captmicr0/Bosch_ME7.1_2.7T_Simulator/Bosch_ME7.1_2.7T_Simulator.png

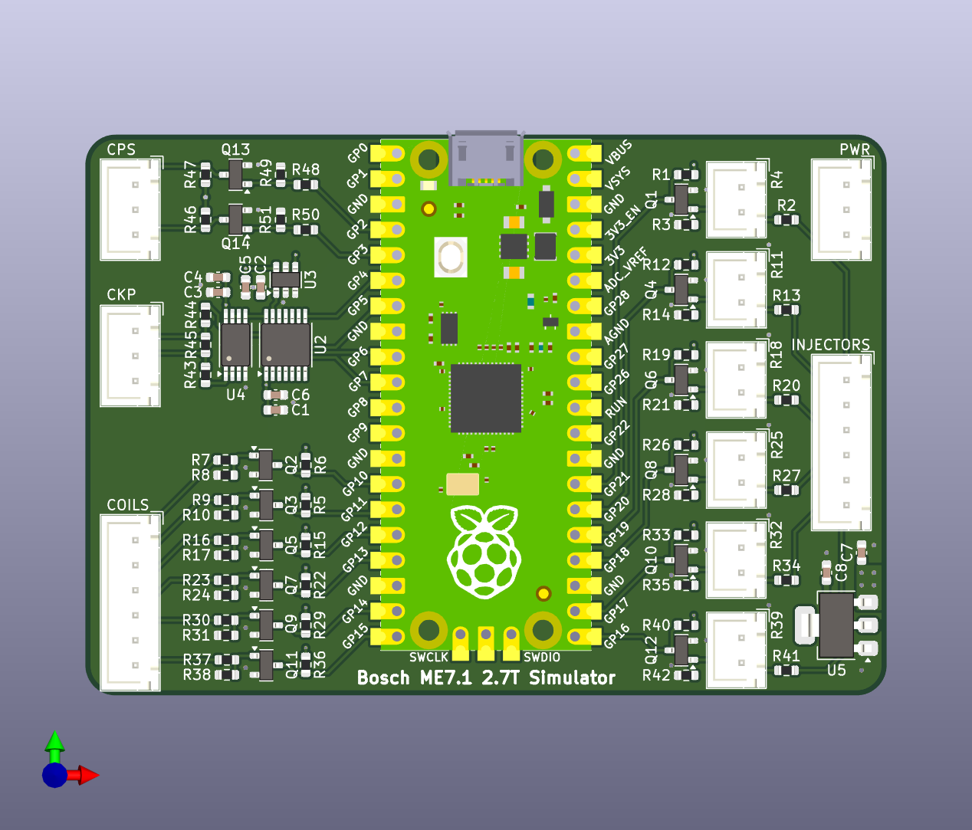
Bosch_ME7.1_2.7T_Simulator.png
