captmicr0/Bosch_ME7.1_2.7T_Simulator/software/Screenshot 2026-11-01 201432.png

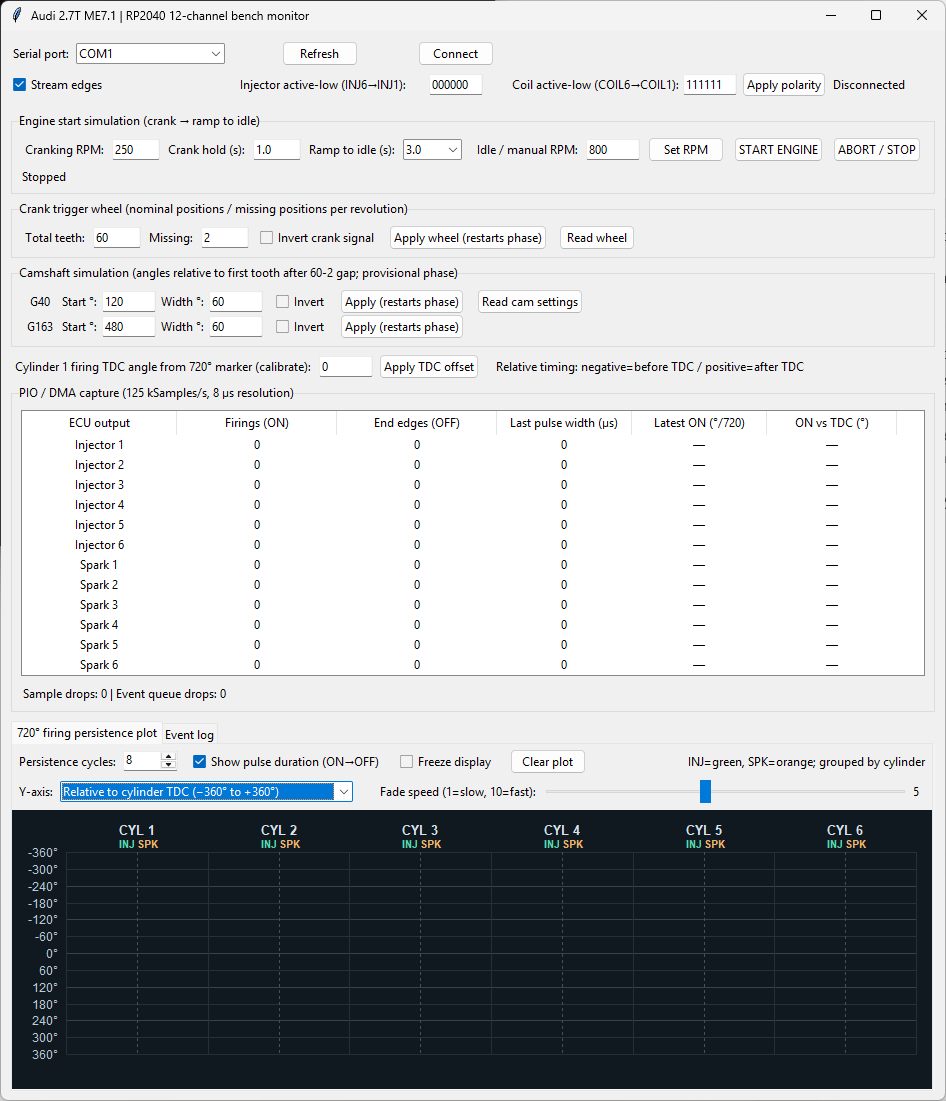
software/Screenshot 2026-11-01 201432.png
