captmicr0/Bosch_ME7.1_2.7T_Simulator/production/bom.csv

Designator | Footprint | Quantity | Value | LCSC Part #
C1, C4, C5, C7, C8 | 0603 | 5 | 1uF
C2, C3, C6 | 0603 | 3 | 100nF
J1 | JST_XH_B6B-XH-AM_1x06_P2.50mm_Vertical | 1 | INJECTORS
J2 | JST_XH_B6B-XH-AM_1x06_P2.50mm_Vertical | 1 | COILS
J3 | JST_XH_B3B-XH-AM_1x03_P2.50mm_Vertical | 1 | CKP
J4 | JST_XH_B3B-XH-AM_1x03_P2.50mm_Vertical | 1 | CPS
J5 | JST_XH_B3B-XH-AM_1x03_P2.50mm_Vertical | 1 | PWR
Q1, Q10, Q11, Q12, Q13, Q14, Q2, Q3, Q4, Q5, Q6, Q7, Q8, Q9 | SOT-23 | 14 | 2N7002
R1, R12, R13, R15, R19, R2, R20, R22, R26, R27, R29, R33, R34, R36, R40, R41, R46, R47, R5, R6 | 0603 | 20 | 4.7k
R10, R17, R24, R31, R38, R49, R51, R8 | 0603 | 8 | 10k
R11, R18, R25, R32, R39, R4 | JST_XH_B2B-XH-AM_1x02_P2.50mm_Vertical | 6 | 15
R14, R21, R28, R3, R35, R42 | 0603 | 6 | 2.2k
R16, R23, R30, R37, R48, R50, R7, R9 | 0603 | 8 | 1k
R43, R44 | 0603 | 2 | 100
R45 | 0603 | 1 | 820
U1 | RPi_Pico_SMD_TH | 1 | Pico
U2 | TSSOP-14_4.4x5mm_P0.65mm | 1 | MCP4922-EST
U3 | SOT-23-6 | 1 | MCP1501-20xCH
U4 | TSSOP-8_4.4x3mm_P0.65mm | 1 | TLV9062
U5 | SOT-223-3_TabPin2 | 1 | AMS1117-5.0
