captmicr0/Bosch_ME7.1_2.7T_Simulator/Bosch_ME7.1_2.7T_Simulator.kicad_pcb

## KiCad design Bosch_ME7.1_2.7T_Simulator.kicad_pcb (2026-11-01)

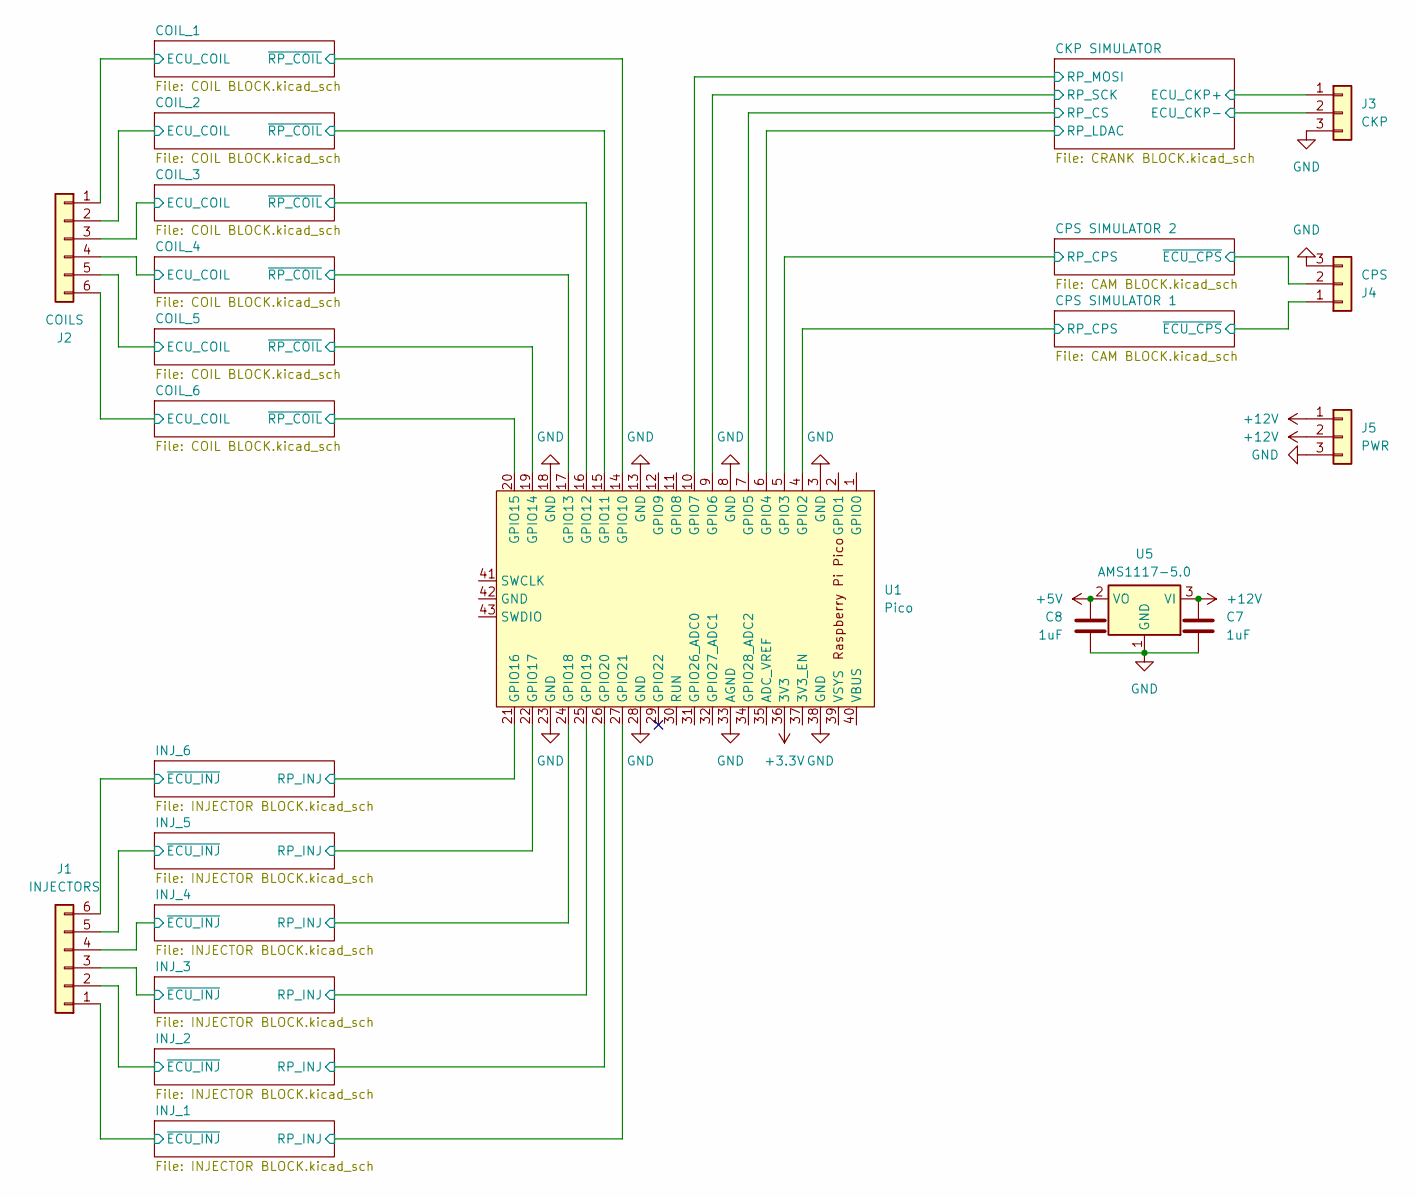
[picture p3: schematic Bosch_ME7.1_2.7T_Simulator.kicad_sch]

Parts:
C7, C8: 1uF; C_0603_1608Metric
J1: INJECTORS; JST_XH_B6B-XH-AM_1x06_P2.50mm_Vertical
J2: COILS; JST_XH_B6B-XH-AM_1x06_P2.50mm_Vertical
J3: CKP; JST_XH_B3B-XH-AM_1x03_P2.50mm_Vertical
J4: CPS; JST_XH_B3B-XH-AM_1x03_P2.50mm_Vertical
J5: PWR; JST_XH_B3B-XH-AM_1x03_P2.50mm_Vertical
U1: Pico; RPi_Pico_SMD_TH
U5: AMS1117-5.0; SOT-223-3_TabPin2

Connections:
+3.3V: U1.36 (3V3); also elsewhere on the board
+5V: C8.1, U5.2 (VO); also elsewhere on the board
+12V: C7.1, J5.1, J5.2, U5.3 (VI); also elsewhere on the board
/CKP SIMULATOR/ECU_CKP+: J3.1; also elsewhere on the board
/CKP SIMULATOR/ECU_CKP-: J3.2; also elsewhere on the board
/CKP SIMULATOR/RP_CS: U1.7 (GPIO5); also elsewhere on the board
/CKP SIMULATOR/RP_LDAC: U1.6 (GPIO4); also elsewhere on the board
/CKP SIMULATOR/RP_MOSI: U1.10 (GPIO7); also elsewhere on the board
/CKP SIMULATOR/RP_SCK: U1.9 (GPIO6); also elsewhere on the board
/COIL_1/ECU_COIL: J2.1; also elsewhere on the board
/COIL_1/~RP_COIL: U1.14 (GPIO10); also elsewhere on the board
/COIL_2/ECU_COIL: J2.2; also elsewhere on the board
/COIL_2/~RP_COIL: U1.15 (GPIO11); also elsewhere on the board
/COIL_3/ECU_COIL: J2.3; also elsewhere on the board
/COIL_3/~RP_COIL: U1.16 (GPIO12); also elsewhere on the board
/COIL_4/ECU_COIL: J2.4; also elsewhere on the board
/COIL_4/~RP_COIL: U1.17 (GPIO13); also elsewhere on the board
/COIL_5/ECU_COIL: J2.5; also elsewhere on the board
/COIL_5/~RP_COIL: U1.19 (GPIO14); also elsewhere on the board
/COIL_6/ECU_COIL: J2.6; also elsewhere on the board
/COIL_6/~RP_COIL: U1.20 (GPIO15); also elsewhere on the board
/CPS SIMULATOR 1/RP_CPS: U1.4 (GPIO2); also elsewhere on the board
/CPS SIMULATOR 1/~ECU_CPS: J4.1; also elsewhere on the board
/CPS SIMULATOR 2/RP_CPS: U1.5 (GPIO3); also elsewhere on the board
/CPS SIMULATOR 2/~ECU_CPS: J4.2; also elsewhere on the board
/INJ_1/RP_INJ: U1.27 (GPIO21); also elsewhere on the board
/INJ_1/~ECU_INJ: J1.1; also elsewhere on the board
/INJ_2/RP_INJ: U1.26 (GPIO20); also elsewhere on the board
/INJ_2/~ECU_INJ: J1.2; also elsewhere on the board
/INJ_3/RP_INJ: U1.25 (GPIO19); also elsewhere on the board
/INJ_3/~ECU_INJ: J1.3; also elsewhere on the board
/INJ_4/RP_INJ: U1.24 (GPIO18); also elsewhere on the board
/INJ_4/~ECU_INJ: J1.4; also elsewhere on the board
/INJ_5/RP_INJ: U1.22 (GPIO17); also elsewhere on the board
/INJ_5/~ECU_INJ: J1.5; also elsewhere on the board
/INJ_6/RP_INJ: U1.21 (GPIO16); also elsewhere on the board
/INJ_6/~ECU_INJ: J1.6; also elsewhere on the board
GND: C7.2, C8.2, J3.3, J4.3, J5.3, U1.3 (GND), U1.8 (GND), U1.13 (GND), U1.18 (GND), U1.23 (GND), U1.28 (GND), U1.33 (AGND), U1.38 (GND), U5.1 (GND); also elsewhere on the board

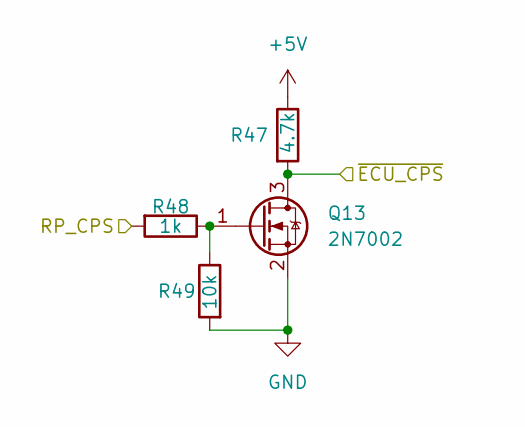
[picture p4: schematic CAM BLOCK.kicad_sch]

Parts:
Q13: 2N7002; SOT-23
R47: 4.7k; R_0603_1608Metric
R48: 1k; R_0603_1608Metric
R49: 10k; R_0603_1608Metric

Connections:
+5V: R47.1; also elsewhere on the board
/CPS SIMULATOR 1/RP_CPS: R48.2; also elsewhere on the board
/CPS SIMULATOR 1/~ECU_CPS: Q13.3 (D), R47.2; also elsewhere on the board
GND: Q13.2 (S), R49.2; also elsewhere on the board
unnamed: Q13.1 (G), R48.1, R49.1

Parts of its further copies:
Q14: 2N7002; SOT-23
R46: 4.7k; R_0603_1608Metric
R50: 1k; R_0603_1608Metric
R51: 10k; R_0603_1608Metric

Connections of its further copies:
+5V: R46.1; also elsewhere on the board
/CPS SIMULATOR 2/RP_CPS: R50.2; also elsewhere on the board
/CPS SIMULATOR 2/~ECU_CPS: Q14.3 (D), R46.2; also elsewhere on the board
GND: Q14.2 (S), R51.2; also elsewhere on the board
unnamed: Q14.1 (G), R50.1, R51.1

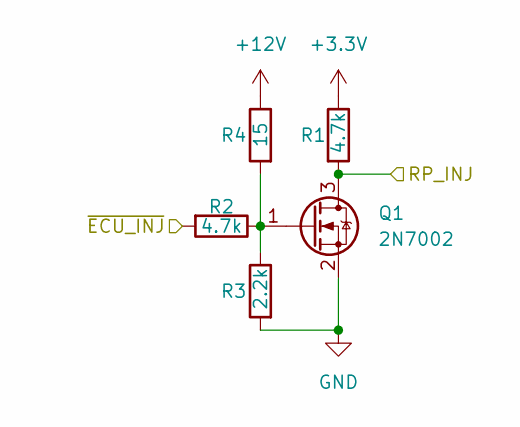
[picture p5: schematic INJECTOR BLOCK.kicad_sch]

Parts:
Q1: 2N7002; SOT-23
R1, R2: 4.7k; R_0603_1608Metric
R3: 2.2k; R_0603_1608Metric
R4: 15; JST_XH_B2B-XH-AM_1x02_P2.50mm_Vertical

Connections:
+3.3V: R1.1; also elsewhere on the board
+12V: R4.1; also elsewhere on the board
/INJ_1/RP_INJ: Q1.3 (D), R1.2; also elsewhere on the board
/INJ_1/~ECU_INJ: R2.2; also elsewhere on the board
GND: Q1.2 (S), R3.2; also elsewhere on the board
unnamed: Q1.1 (G), R2.1, R3.1, R4.2

Parts of its further copies:
Q4, Q6, Q8, Q10, Q12: 2N7002; SOT-23
R11, R18, R25, R32, R39: 15; JST_XH_B2B-XH-AM_1x02_P2.50mm_Vertical
R12, R13, R19, R20, R26, R27, R33, R34, R40, R41: 4.7k; R_0603_1608Metric
R14, R21, R28, R35, R42: 2.2k; R_0603_1608Metric

Connections of its further copies:
+3.3V: R12.1, R19.1, R26.1, R33.1, R40.1; also elsewhere on the board
+12V: R11.1, R18.1, R25.1, R32.1, R39.1; also elsewhere on the board
/INJ_2/RP_INJ: Q4.3 (D), R12.2; also elsewhere on the board
/INJ_2/~ECU_INJ: R13.2; also elsewhere on the board
/INJ_3/RP_INJ: Q6.3 (D), R19.2; also elsewhere on the board
/INJ_3/~ECU_INJ: R20.2; also elsewhere on the board
/INJ_4/RP_INJ: Q8.3 (D), R26.2; also elsewhere on the board
/INJ_4/~ECU_INJ: R27.2; also elsewhere on the board
/INJ_5/RP_INJ: Q10.3 (D), R33.2; also elsewhere on the board
/INJ_5/~ECU_INJ: R34.2; also elsewhere on the board
/INJ_6/RP_INJ: Q12.3 (D), R40.2; also elsewhere on the board
/INJ_6/~ECU_INJ: R41.2; also elsewhere on the board
GND: Q4.2 (S), Q6.2 (S), Q8.2 (S), Q10.2 (S), Q12.2 (S), R14.2, R21.2, R28.2, R35.2, R42.2; also elsewhere on the board
unnamed: Q4.1 (G), R11.2, R13.1, R14.1
unnamed: Q6.1 (G), R18.2, R20.1, R21.1
unnamed: Q8.1 (G), R25.2, R27.1, R28.1
unnamed: Q10.1 (G), R32.2, R34.1, R35.1
unnamed: Q12.1 (G), R39.2, R41.1, R42.1

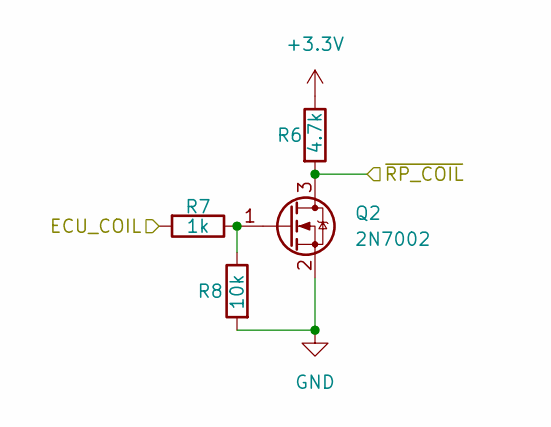
[picture p6: schematic COIL BLOCK.kicad_sch]

Parts:
Q2: 2N7002; SOT-23
R6: 4.7k; R_0603_1608Metric
R7: 1k; R_0603_1608Metric
R8: 10k; R_0603_1608Metric

Connections:
+3.3V: R6.1; also elsewhere on the board
/COIL_1/ECU_COIL: R7.2; also elsewhere on the board
/COIL_1/~RP_COIL: Q2.3 (D), R6.2; also elsewhere on the board
GND: Q2.2 (S), R8.2; also elsewhere on the board
unnamed: Q2.1 (G), R7.1, R8.1

Parts of its further copies:
Q3, Q5, Q7, Q9, Q11: 2N7002; SOT-23
R5, R15, R22, R29, R36: 4.7k; R_0603_1608Metric
R9, R16, R23, R30, R37: 1k; R_0603_1608Metric
R10, R17, R24, R31, R38: 10k; R_0603_1608Metric

Connections of its further copies:
+3.3V: R5.1, R15.1, R22.1, R29.1, R36.1; also elsewhere on the board
/COIL_2/ECU_COIL: R9.2; also elsewhere on the board
/COIL_2/~RP_COIL: Q3.3 (D), R5.2; also elsewhere on the board
/COIL_3/ECU_COIL: R16.2; also elsewhere on the board
/COIL_3/~RP_COIL: Q5.3 (D), R15.2; also elsewhere on the board
/COIL_4/ECU_COIL: R23.2; also elsewhere on the board
/COIL_4/~RP_COIL: Q7.3 (D), R22.2; also elsewhere on the board
/COIL_5/ECU_COIL: R30.2; also elsewhere on the board
/COIL_5/~RP_COIL: Q9.3 (D), R29.2; also elsewhere on the board
/COIL_6/ECU_COIL: R37.2; also elsewhere on the board
/COIL_6/~RP_COIL: Q11.3 (D), R36.2; also elsewhere on the board
GND: Q3.2 (S), Q5.2 (S), Q7.2 (S), Q9.2 (S), Q11.2 (S), R10.2, R17.2, R24.2, R31.2, R38.2; also elsewhere on the board
unnamed: Q3.1 (G), R9.1, R10.1
unnamed: Q5.1 (G), R16.1, R17.1
unnamed: Q7.1 (G), R23.1, R24.1
unnamed: Q9.1 (G), R30.1, R31.1
unnamed: Q11.1 (G), R37.1, R38.1

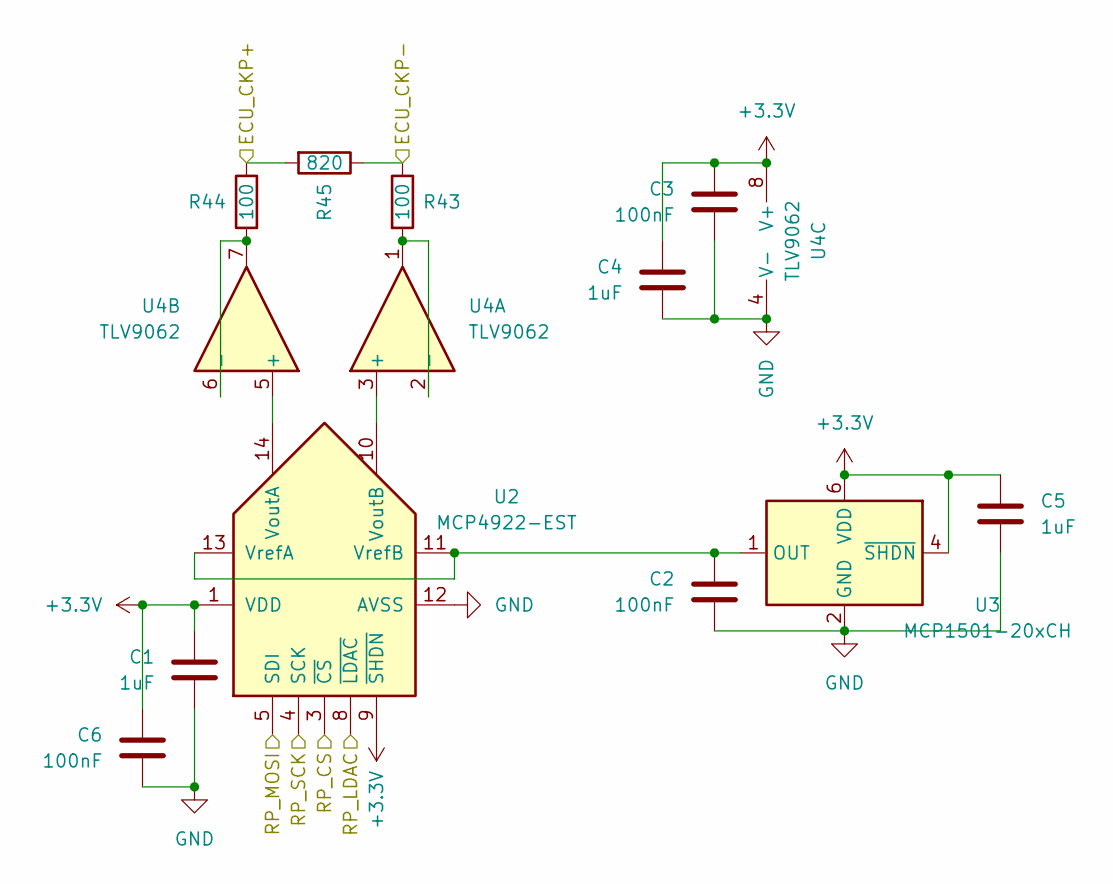
[picture p7: schematic CRANK BLOCK.kicad_sch]

Parts:
C1, C4, C5: 1uF; C_0603_1608Metric
C2, C3, C6: 100nF; C_0603_1608Metric
R43, R44: 100; R_0603_1608Metric
R45: 820; R_0603_1608Metric
U2: MCP4922-EST; TSSOP-14_4.4x5mm_P0.65mm
U3: MCP1501-20xCH; SOT-23-6
U4: TLV9062; TSSOP-8_4.4x3mm_P0.65mm

Connections:
+3.3V: C1.1, C3.1, C4.1, C5.1, C6.1, U2.1 (VDD), U2.9 (~SHDN), U3.4 (~SHDN), U3.6 (VDD), U4.8 (V+); also elsewhere on the board
/CKP SIMULATOR/ECU_CKP+: R44.1, R45.2; also elsewhere on the board
/CKP SIMULATOR/ECU_CKP-: R43.1, R45.1; also elsewhere on the board
/CKP SIMULATOR/RP_CS: U2.3 (~CS); also elsewhere on the board
/CKP SIMULATOR/RP_LDAC: U2.8 (~LDAC); also elsewhere on the board
/CKP SIMULATOR/RP_MOSI: U2.5 (SDI); also elsewhere on the board
/CKP SIMULATOR/RP_SCK: U2.4 (SCK); also elsewhere on the board
GND: C1.2, C2.2, C3.2, C4.2, C5.2, C6.2, U2.12 (AVSS), U3.2 (GND), U3.3 (GND), U3.5 (GND), U4.4 (V-); also elsewhere on the board
unnamed: U2.14 (VoutA), U4.5 (+)
unnamed: U2.10 (VoutB), U4.3 (+)
unnamed: C2.1, U2.11 (VrefB), U2.13 (VrefA), U3.1 (OUT)
unnamed: R43.2, U4.1, U4.2 (-)
unnamed: R44.2, U4.6 (-), U4.7

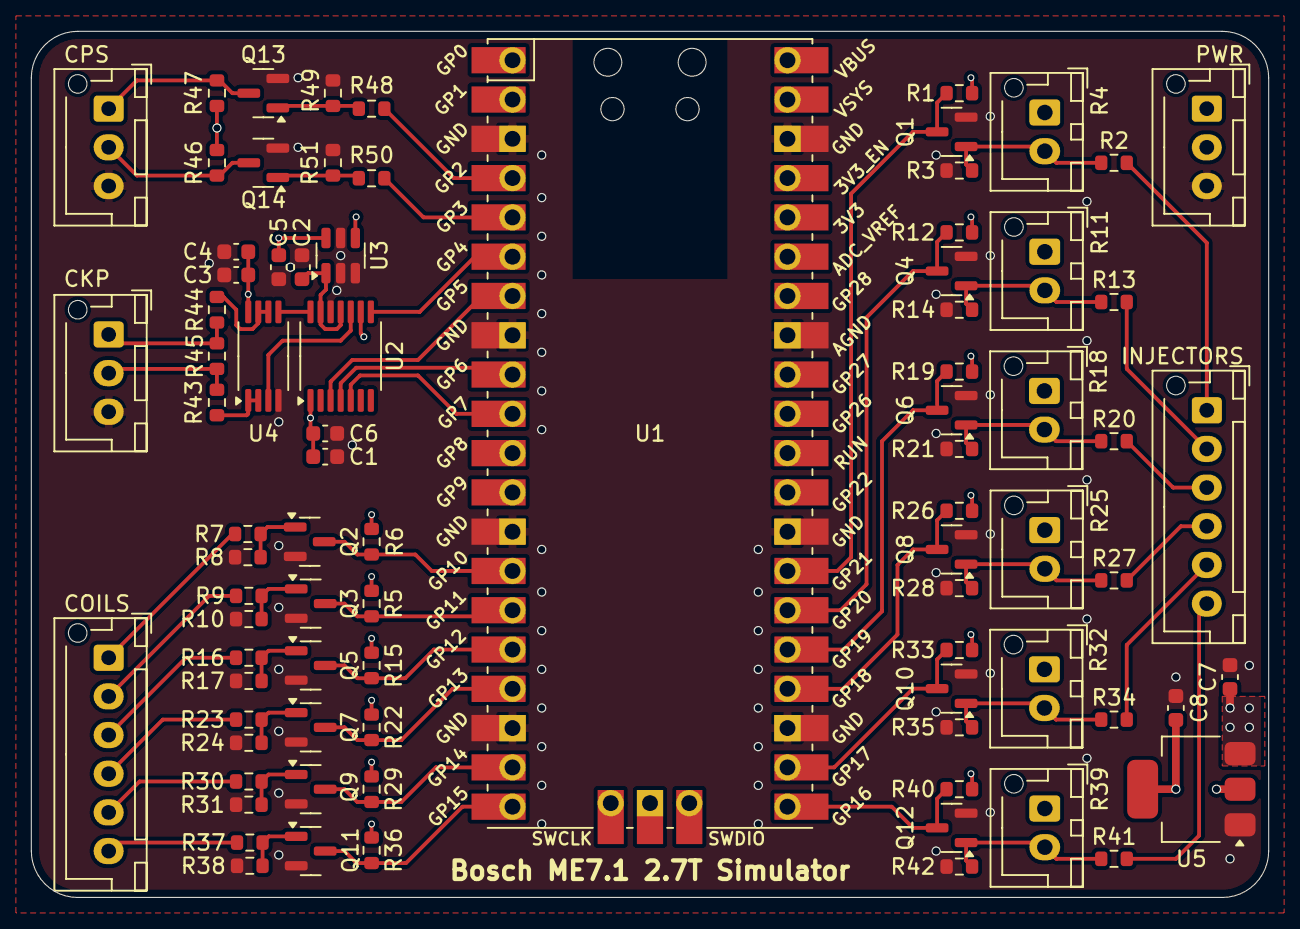
[picture p8: board Bosch_ME7.1_2.7T_Simulator.kicad_pcb from above]

Board: 4 copper layers, 80.0 x 56.0 mm, 83 parts (0 on the bottom side), 57 nets.
