captmicr0/Bosch_ME7.1_2.7T_Simulator/(commit log)

2026-11-01 updated FW to use LED on GPIO16. GPIO26 now INJ7
2026-11-01 updated FW to use LED on GPIO23. fixed INJ6 GPIO
    [main.c]
